gemarcano/wifi_pc_power_switch/(threads)

Thread 1 (2024-11-17):

Add a reset button

gemarcano, 2024-11-17:
It's a royal pain to reset the board if the software hangs, as it requires pulling power (or shorting the reset pin, but that's also a pain).

gemarcano, 2024-11-26:
Added in 0155b61027025464fed4fbbf1b67137adf696be9.

Closed 2024-11-26.

Thread 2 (2024-11-17):

Add LED indicator for 5V input rail

gemarcano, 2024-11-17:
Right now it's very difficult to determine if the 5V input (non-USB) on the board is receiving power. This is used by the 5VSB connection on my ATX motherboard.

gemarcano, 2024-11-26:
Added in current Rev B (commit 0155b61027025464fed4fbbf1b67137adf696be9).

Closed 2024-11-26.

Thread 3 (2024-11-17):

Firmware: Crashes intermittently after a long while

gemarcano, 2024-11-17:
Need to implement better logging that either sends it somewhere or stores somewhere in SRAM that survives reboot. But after 8+ hours the pico reboots probably due to a crash.

gemarcano, 2024-12-06:
My guess is that there's some kind of buffer overflow happening with logging. I thought I limited the amount of memory being used by logging... I'll double check the logic. Another option I have is I can add a loop that just prints crap to log continuously to try to crash the system faster.

gemarcano, 2024-12-06:
Should be fixed by https://github.com/gemarcano/gpico/commit/f45d731c7d10dc535cbf3f118748629627a8f622 . Effectively we were using too much heap memory, since we don't know the overhead malloc requires, and aren't taking into account possible fragmentation. Just massively reduce the log size which should be pretty safe even with 10x overhead (honestly, we can probably increase the log size by 5x and still be fine).

Closed 2024-12-06.

Thread 4 (2024-11-17):

Firmware: moving CLI task initialization before WiFi leads to a crash

gemarcano, 2024-11-17:
See title. Will probably need to connect a debugger to see what's going on. I've already tried increasing heap and stack size, but that doesn't seem to work.

gemarcano, 2024-11-26:
Figured out the cause. It was resource starvation. FreeRTOS always runs tasks at the highest priority, and if these never block/sleep, they will starve lower priority tasks.

I've applied 2 fixes:
 1. Switch TinyUSB implementation to use FreeRTOS support, making the USB task actually block
 2. Change priorities around as there are some tasks made by pico-sdk networking that are only `idle+1`.

Closed 2024-11-26.
