gemarcano/wifi_pc_power_switch/design/wifi_pc_power_switch-F_Silkscreen.pdf

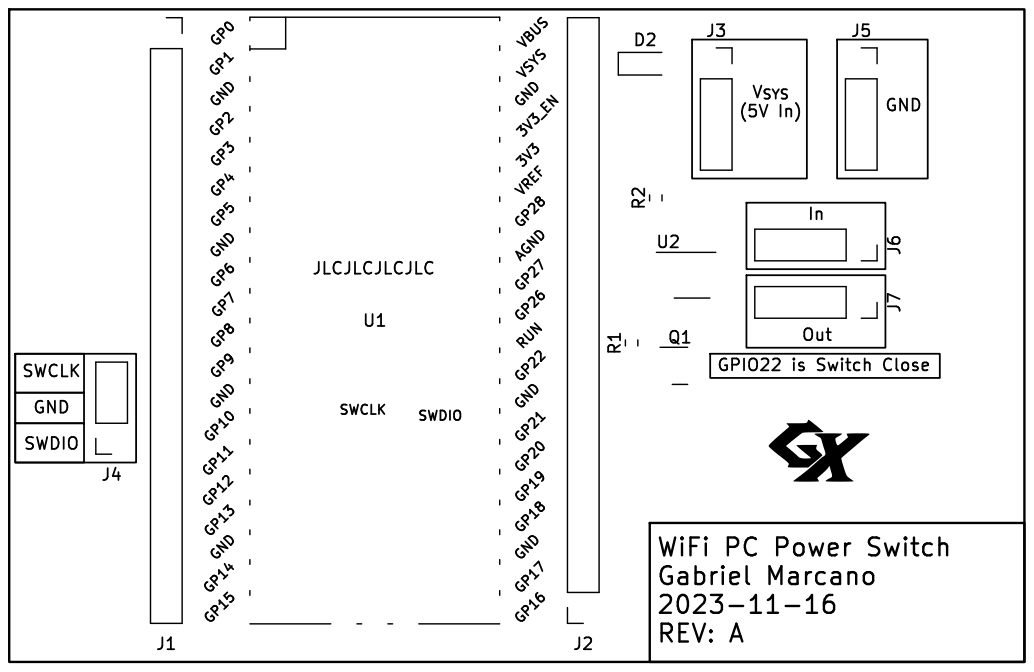
[picture p1: page 1]

GPIO22 is Switch Close GND
