gemarcano/wifi_pc_power_switch/design/wifi_pc_power_switch.pdf

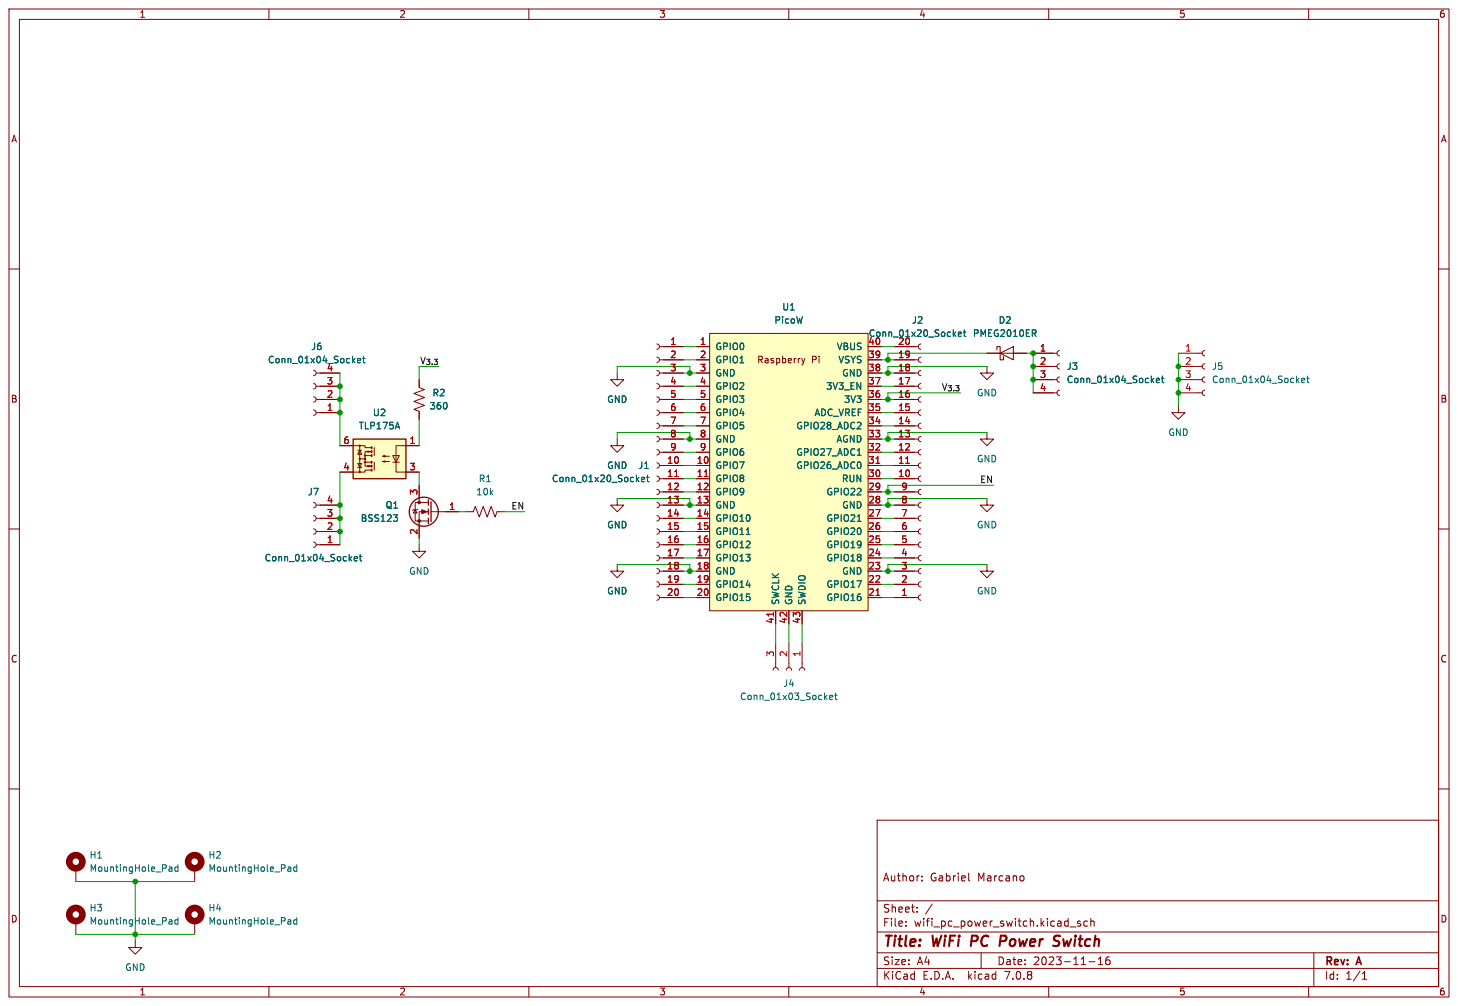
[picture p2: page 1]

Id: 1/1 Title: WiFi PC Power Switch
