gemarcano/wifi_pc_power_switch/design/wifi_pc_power_switch-B_Cu.pdf

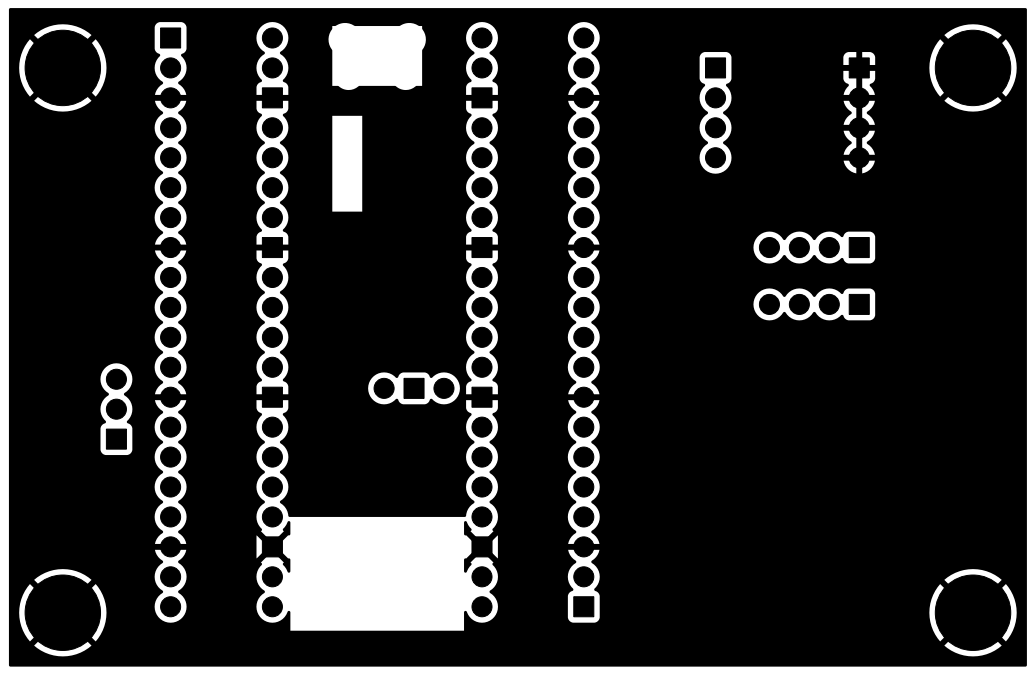
[picture p3: page 1]
