gemarcano/wifi_pc_power_switch/design/wifi_pc_power_switch-B_Mask.pdf

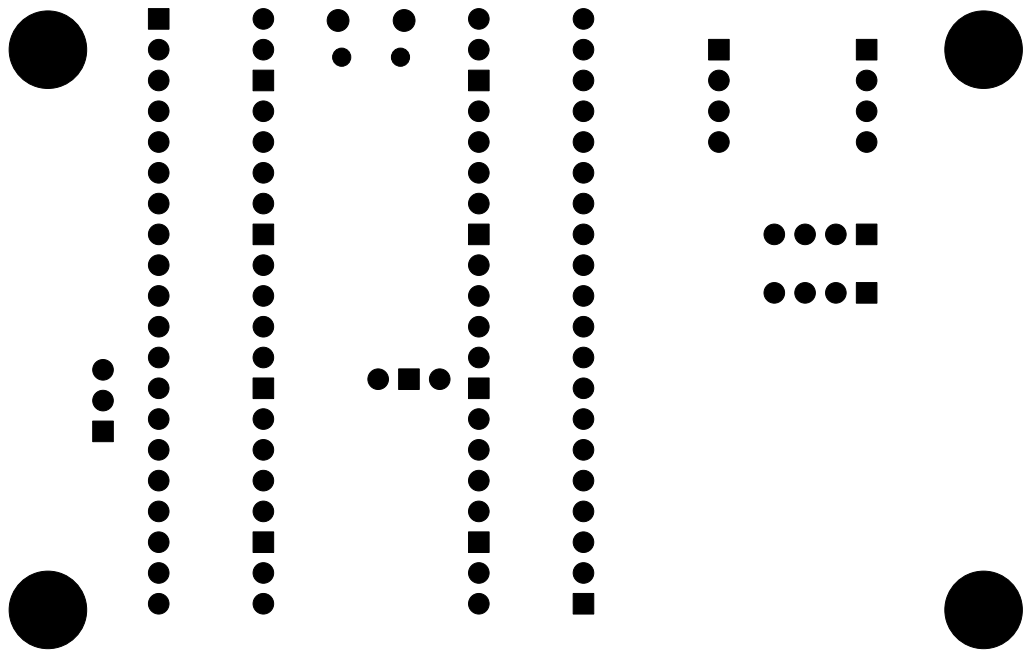
[picture p4: page 1]
