gemarcano/wifi_pc_power_switch/design/wifi_pc_power_switch-F_Cu.pdf

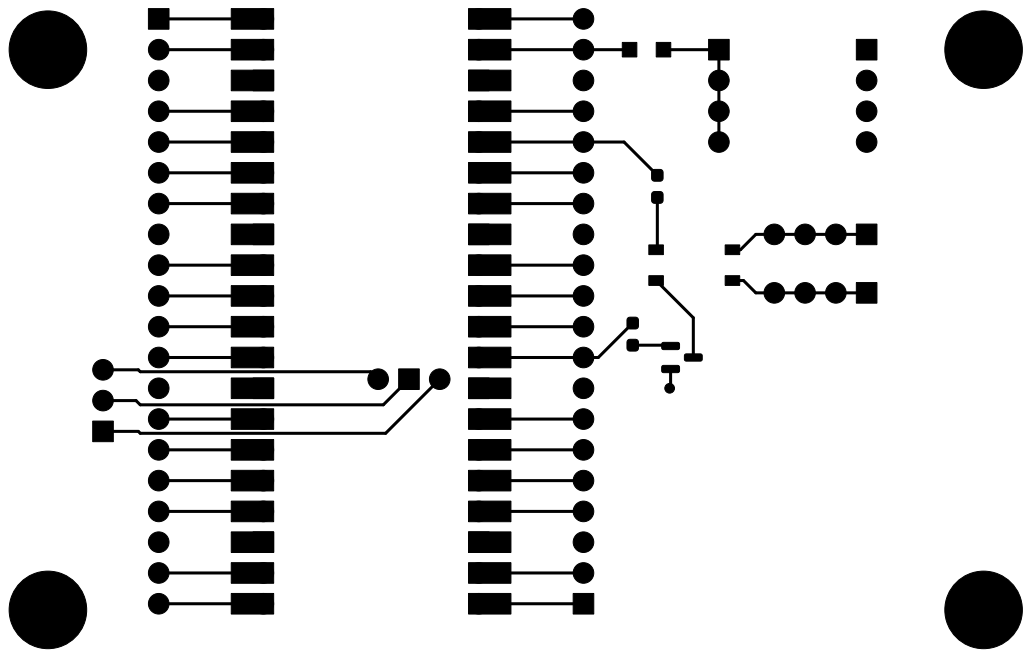
[picture p5: page 1]
