gemarcano/wifi_pc_power_switch/design/wifi_pc_power_switch-F_Mask.pdf

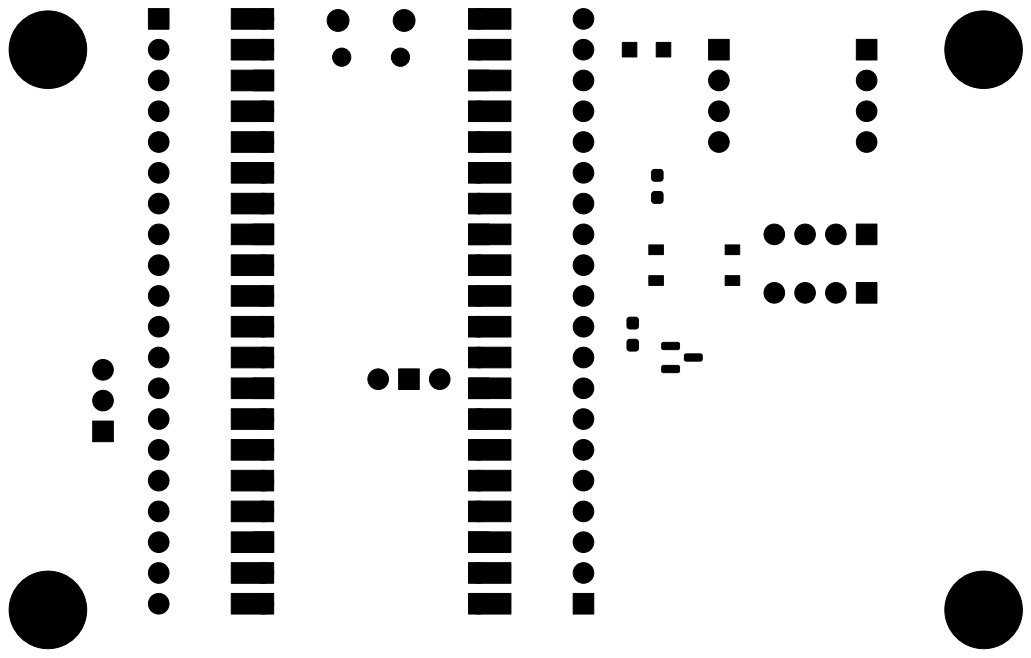
[picture p6: page 1]
