gemarcano/wifi_pc_power_switch/design/wifi_pc_power_switch-F_Paste.pdf

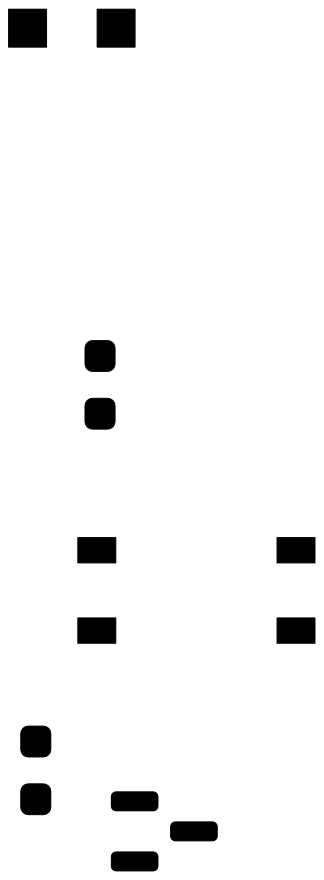
[picture p7: page 1]
