gemarcano/wifi_pc_power_switch/design/wifi_pc_power_switch_pcb.pdf

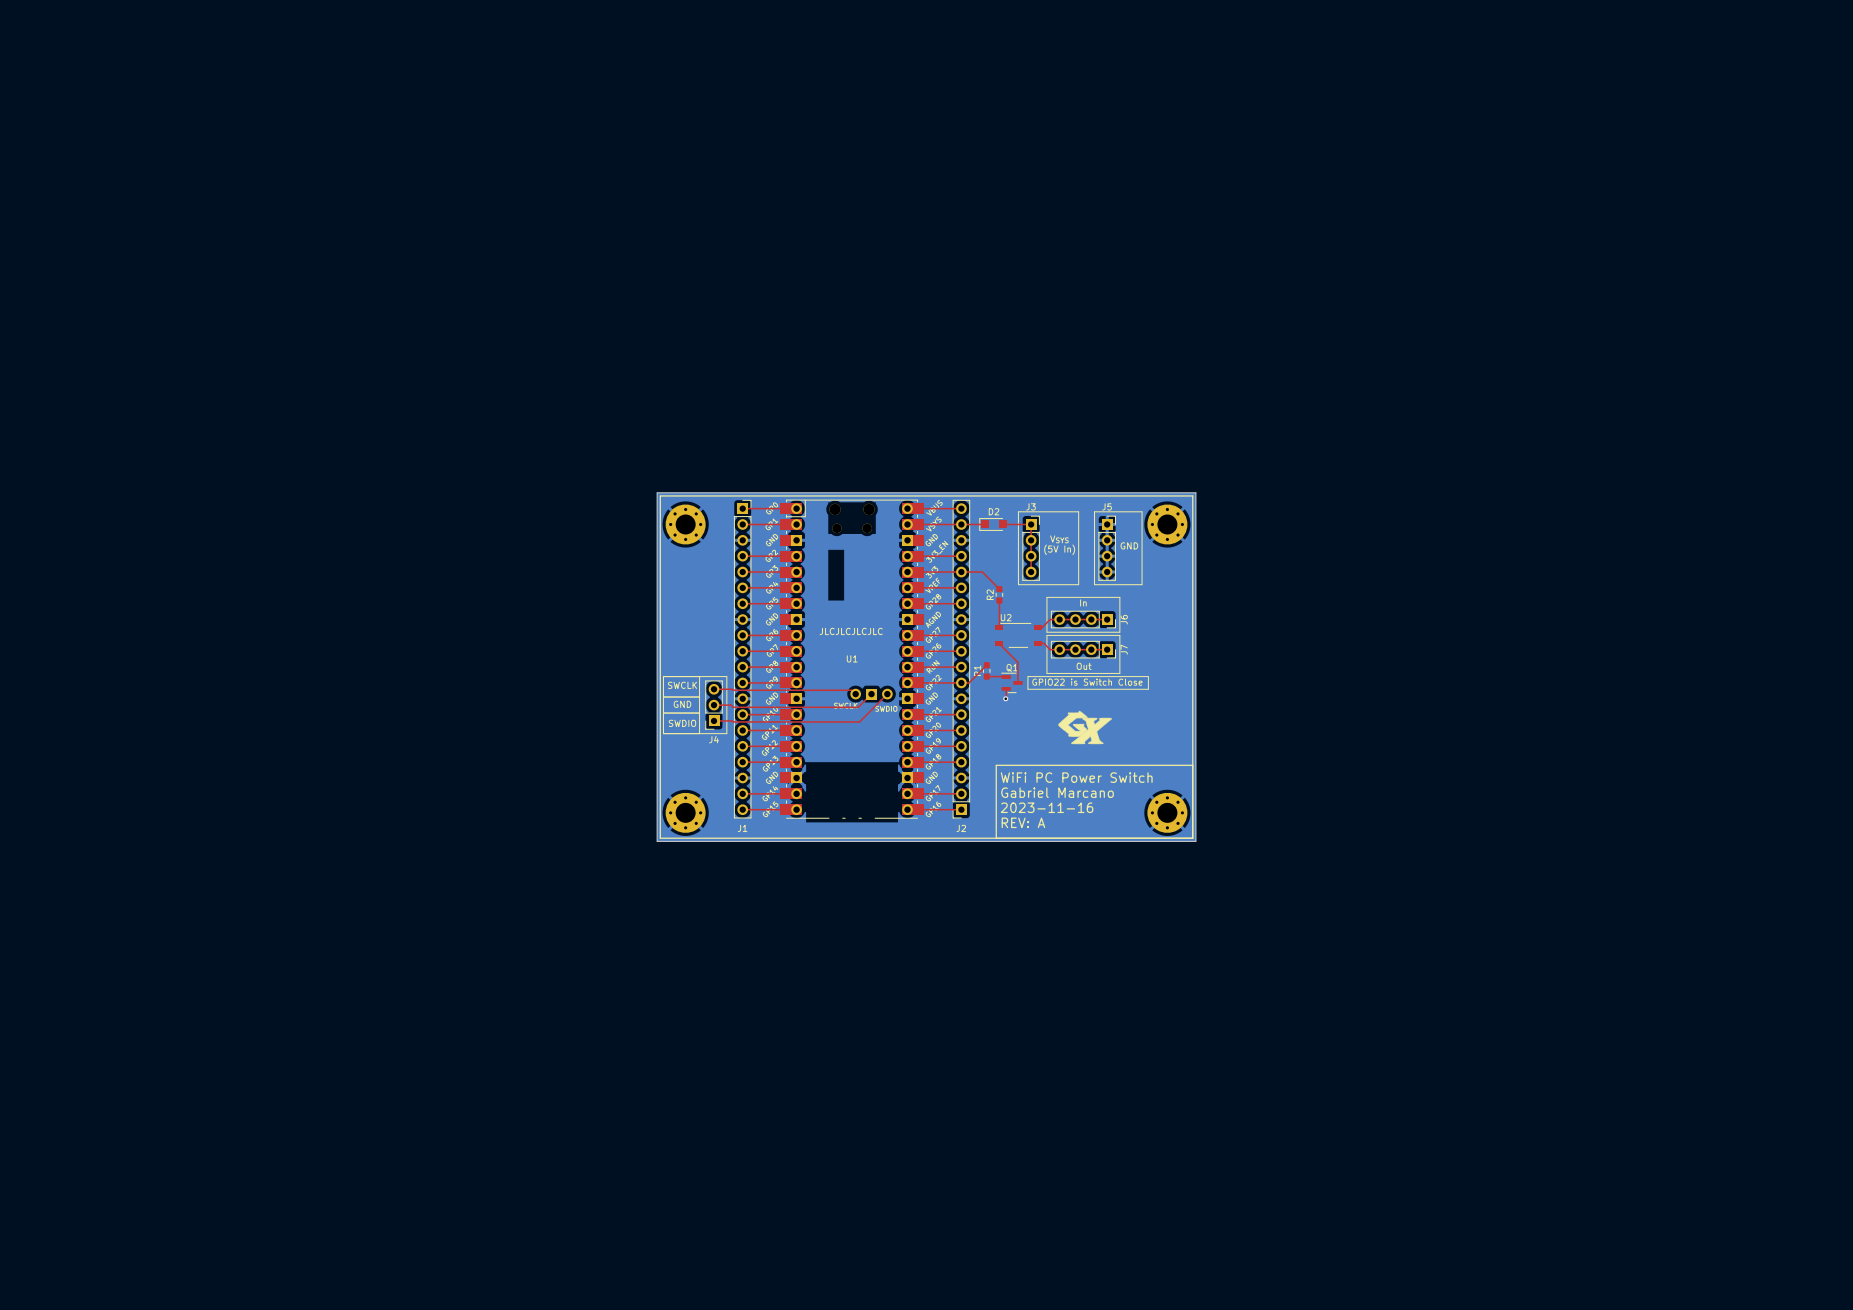
[picture p8: page 1]
