gemarcano/wifi_pc_power_switch/wifi_pc_power_switch.kicad_pcb

## KiCad design wifi_pc_power_switch.kicad_pcb (2025-06-24)

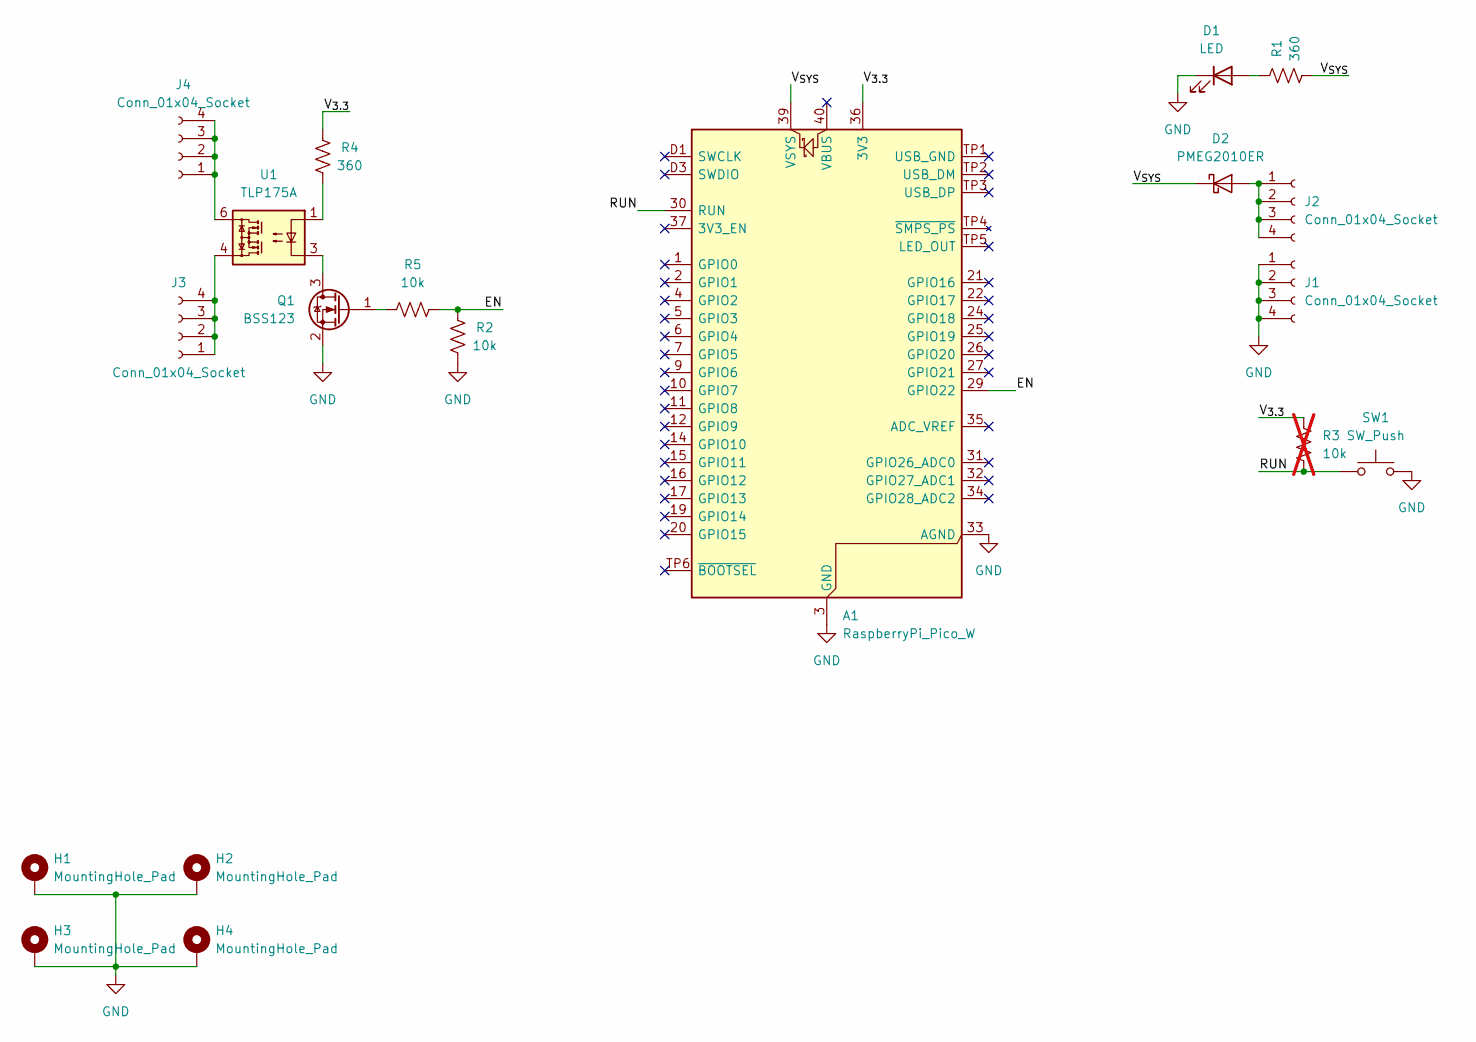
[picture p9: schematic wifi_pc_power_switch.kicad_sch, WiFi PC Power Switch]

Parts:
A1: RaspberryPi_Pico_W; RaspberryPi_Pico_W_Common_Unspecified
D1: LED; LED_0603_1608Metric_Pad1.05x0.95mm_HandSolder
D2: PMEG2010ER; Nexperia_CFP3_SOD-123W
H1, H2, H3, H4: MountingHole_Pad; MountingHole_3.2mm_M3_Pad_Via
J1, J2, J3, J4: Conn_01x04_Socket; PinSocket_1x04_P2.54mm_Vertical
Q1: BSS123; SOT-23
R1, R4: 360; R_0603_1608Metric_Pad0.98x0.95mm_HandSolder
R2, R5: 10k; R_0603_1608Metric_Pad0.98x0.95mm_HandSolder
R3: 10k; R_0603_1608Metric_Pad0.98x0.95mm_HandSolder; not fitted
SW1: SW_Push; PTS636_SM50_SMTR_LFS
U1: TLP175A; MFSOP6-4_4.4x3.6mm_P1.27mm

Connections:
/EN: A1.29 (GPIO22), R2.2, R5.2
/RUN: A1.30 (RUN), R3.2, SW1.1
/V_{3.3}: A1.36 (3V3), R3.1, R4.2
/V_{SYS}: A1.39 (VSYS), D2.1 (K), R1.1
GND: A1.3 (GND), A1.8 (GND), A1.13 (GND), A1.18 (GND), A1.23 (GND), A1.28 (GND), A1.33 (AGND), A1.38 (GND), A1.D2 (GND), D1.1 (K), H1.1, H2.1, H3.1, H4.1, J1.1, J1.2, J1.3, J1.4, Q1.2 (S), R2.1, SW1.2
unnamed: D1.2 (A), R1.2
unnamed: D2.2 (A), J2.1, J2.2, J2.3, J2.4
unnamed: J3.1, J3.2, J3.3, J3.4, U1.4
unnamed: J4.1, J4.2, J4.3, J4.4, U1.6
unnamed: Q1.3 (D), U1.3
unnamed: Q1.1 (G), R5.1
unnamed: R4.1, U1.1

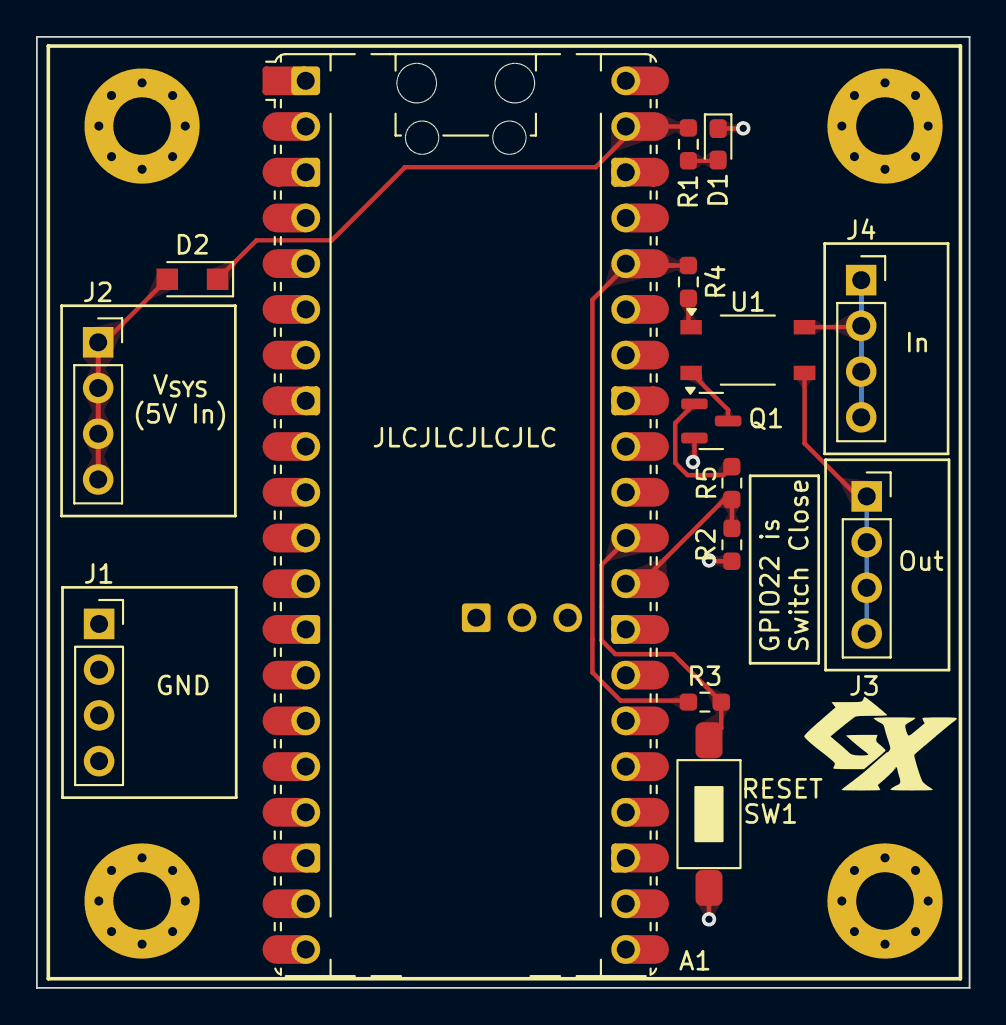
[picture p10: board wifi_pc_power_switch.kicad_pcb from above]

Board: 2 copper layers, 51.8 x 52.8 mm, 19 parts (0 on the bottom side), 12 nets.
