gemarcano/wifi_pc_power_switch/firmware/src/ntp.cpp

// SPDX-License-Identifier: GPL-2.0-or-later OR LGPL-2.1-or-later
// SPDX-FileCopyrightText: Gabriel Marcano, 2023 - 2024
/// @file

#include <pcrb/ntp.h>

#include <FreeRTOS.h>
#include <queue.h>
#include <task.h>

#include <pico/stdlib.h>
#include <pico/cyw43_arch.h>

#include <pcrb/switch.h>
#include <pcrb/server.h>

#include <lwip/dns.h>
#include <lwip/pbuf.h>
#include <lwip/udp.h>
#include <lwip/sockets.h>
#include <lwip/netdb.h>

#include <cstring>
#include <ctime>
#include <memory>
#include <expected>
#include <atomic>

constexpr const char* NTP_SERVER = "pool.ntp.org";
constexpr const int NTP_MSG_LEN = 48;
constexpr const int NTP_PORT = 123;
constexpr const int NTP_DELTA = 2208988800; // seconds between 1 Jan 1900 and 1 Jan 1970
constexpr const int ntpEST_TIME = (30 * 1000);
constexpr const int NTP_FAIL_TIME = (10 * 1000);

ntp_client::ntp_client()
{
	ip_addr_t dns_server;
	cyw43_arch_lwip_begin();
	inet_pton(AF_INET, "1.1.1.1", &dns_server);
	dns_setserver(0, &dns_server);
	cyw43_arch_lwip_end();
}

int ntp_client::request()
{
	// Look up IP address of NTP server first, in case we're looking at an
	// NTP pool
	const addrinfo ntp_info = {
		.ai_flags = 0,
		.ai_family = AF_UNSPEC,
		.ai_socktype = SOCK_DGRAM,
		.ai_protocol = 0,
	};
	addrinfo *dns_result = NULL;
	printf("Trying DNS...\n");
	int err = getaddrinfo(NTP_SERVER, "123", &ntp_info, &dns_result);
	printf("DNS err: %d %p\n", err, dns_result);
	printf("High water mark: %lu\n", uxTaskGetStackHighWaterMark(NULL));
	printf("%d %d %d\n", dns_result->ai_family, dns_result->ai_socktype, dns_result->ai_protocol);
	int s = socket(dns_result->ai_family, dns_result->ai_socktype, dns_result->ai_protocol);
	printf("socket: %d\n", s);
	timeval timeout = {
		.tv_sec = 5,
	};
	setsockopt(s, SOL_SOCKET, SO_RCVTIMEO, &timeout, sizeof(timeout));
	err = connect(s, dns_result->ai_addr, dns_result->ai_addrlen);
	printf("connect err: %d\n", err);
	freeaddrinfo(dns_result);

	unsigned char request[NTP_MSG_LEN] = {0};
	request[0] = 0x1b;
	int amount = send(s, request, NTP_MSG_LEN, 0);
	printf("amount sent: %d\n", amount);
	amount = ::recv(s, request, NTP_MSG_LEN, 0);
	printf("amount received: %d\n", amount);
	close(s);

	uint8_t mode = request[0] & 0x7;
	uint8_t stratum = request[1];

	// Check the result
	if (amount == NTP_MSG_LEN &&
		mode == 0x4 &&
		stratum != 0)
	{
		uint8_t seconds_buf[4] = {};
		memcpy(seconds_buf, request + 40, 4);
		uint32_t seconds_since_1900 = seconds_buf[0] << 24 | seconds_buf[1] << 16 | seconds_buf[2] << 8 | seconds_buf[3];
		uint32_t seconds_since_1970 = seconds_since_1900 - NTP_DELTA;
		time_t epoch = seconds_since_1970;
		struct tm *utc = gmtime(&epoch);
		printf("got ntp response: %02d/%02d/%04d %02d:%02d:%02d\n", utc->tm_mday, utc->tm_mon + 1, utc->tm_year + 1900,
			   utc->tm_hour, utc->tm_min, utc->tm_sec);
		ntp_timeout_time = make_timeout_time_ms(ntpEST_TIME);
		return 0;
	}

	printf("invalid ntp response\n");
	return -1;
}

bool ntp_client::time_elapsed() const
{
	printf("diff: %lld\n", absolute_time_diff_us(get_absolute_time(), ntp_timeout_time));
	return absolute_time_diff_us(get_absolute_time(), ntp_timeout_time) < 0;
}
