gemarcano/wifi_pc_power_switch/firmware/src/network_task.cpp

// SPDX-License-Identifier: GPL-2.0-or-later OR LGPL-2.1-or-later
// SPDX-FileCopyrightText: Gabriel Marcano, 2023 - 2024
/// @file

#include <pcrb/network_task.h>
#include <pcrb/switch_task.h>
#include <pcrb/server.h>

#include <gpico/log.h>

#include <cstdint>
#include <cstdio>
#include <format>
#include <cstring>

using gpico::sys_log;

namespace pcrb
{

void network_task(void*)
{
	// Loop endlessly, restarting the server if there are errors
	server server_;

	for(;;)
	{
		// FIXME maybe move wifi initialization here?
		int err;
		do
		{
			err = server_.listen(48686);
			if (err != 0)
			{
				sys_log.push(std::format("unable to listen on server, error {}", err));
			}
		} while (err != 0);

		for(;;)
		{
			auto accept_result = server_.accept();
			if (!accept_result)
			{
				sys_log.push(std::format("unable to accept socket, error {}", accept_result.error()));
				// FIXME what if the error is terminal? Are there any terminal errors?
				continue;
			}
			sys_log.push("new connection accepted");
			auto request_result = server_.handle_request(std::move(*accept_result));
			if (request_result)
			{
				if (request_result.value().size() != 4)
				{
					sys_log.push(std::format("Received bad network request with size {}", request_result.value().size()));
					continue;
				}
				uint32_t request;
				memcpy(&request, request_result.value().data(), request_result.value().size());
				request = ntoh(request);
				sys_log.push(std::format("Received network request {}", request));
				xQueueSendToBack(switch_comms.get(), &request, 0);
			}
			else
				sys_log.push(std::format("failed to handle request: {}", request_result.error()));
		}

		server_.close();
	}
}

}
