gemarcano/wifi_pc_power_switch/(commit log)

2023-11-09 Switch to using sockets API
2023-11-17 Add pull-down to establish default switch state
    - Also force keep-out areas to be where they matter-- for USB and
    antenna, keep-out for both top and bottom layers. For test pads,
    keep-out only on top layer.
    [wifi_pc_power_switch.kicad_pcb, wifi_pc_power_switch.kicad_sch]
2023-12-07 Reorganize source directories
    - Initial GPIO implementation to control solid state relay
2023-12-09 Remove NTP from main
    - This project doesn't really need NTP
    [main.cpp]
2023-12-16 Better FreeRTOS malloc support
    - Turns out that for multi-thread malloc support we need to implement
    recursive locking of the malloc control structures through
    __malloc_lock and __malloc_unlock
    - Enable Newlib _reent support in FreeRTOS
    - Enable static allocation support in FreeRTOS
2023-12-23 Trivial CLI support, lwip status callbacks
    - Register trivial handlers to detect when lwip network status changes
    - Add a trivial CLI interface to toggle the switch over USB, and to
    query basic network state
2023-12-23 Add syslog support, cleanup init printing
    - Also, just move all initialization to the init_task-- it really just
    looks like with FreeRTOS the pico-sdk just makes too many assumptions
    that tasks, mutex/spinlocks, etc. are running inside tasks, so do the
    absolute bare minimum in main() to launch a FreeRTOS task.
2023-12-23 socket wrapper class, new namespace
    - Make new socket wrapper class, to handle closing automatically
    - Stick server and socket classes in new pc_remote_button namespace, to
    prevent clash with global namespace symbols
    [main.cpp]
2023-12-23 removed custom malloc protection, watchdog support
    - Turns out the pico-sdk is already doing locking through __wrap_malloc
    and friends. Something weird was going on that was causing a race
    between the two cores with my custom implementation, leading to a
    vListInsert looping forever because the node points to itself. I'm
    still not sure why this manifests (supposedly interrupt priority
    errors in Cortex-Ms are a usual suspect, as well as stack overflows).
    - Enable watchdog support. In case we do end up crashing, now this
    should enable us to recover automatically
    [main.cpp]
2023-12-25 Add more error checking for networking
    - Loop server init and close in case of errors
    [main.cpp]
2024-01-14 Move most output to log, track time in log
    - Status output now also prints logs
2024-01-14 Move switch into switch task
    - Ensure only switch task can control switch
2024-01-15 Replace snprintf with std::format
    [main.cpp]
2024-01-15 Refactor out of main, use newlib errno
    - Refactor most tasks out of main.cpp, and isolate them as much as
    possible
    - switch_task exposes a global singleton to access the switch queue to
    pass switch times
    - Change copyright years
    - log exposes sys_log global log variable
    - Apparently pico-sdk uses LWIP_PROVIDE_ERRNO = 1, which makes newlib
    throw up a ton of warnings depending on the include order. Undef it
    and let LWIP use newlib's errno instead
2024-01-16 Log when switch is toggled
2024-01-16 Force a full reset if we fail initialization
    [main.cpp]
2024-01-16 socket debug logging, fix socket move, stack size
    - Add more logging to view stack watermark
    - Increase CLI stack, was overflowing
    - Fix socket move constructor, always initialize internal socket handle
    [cli_task.cpp, main.cpp, network_task.cpp, server.cpp, switch_task.cpp]
2024-01-16 Improve handle_request move, shutup GCC format abi
    - Take socket by value forcing a move in handle_request, which also
    leads to automatic destruction of the object on function return as
    intended
    - add -Wno-psabi to shut up GCC from throwing up notices on std::format
    use
2024-01-17 Disable powersaving mode
    - Trying to improve reliability-- disable power saving in WiFi. We're
    plugged into main power so this should be fine. Doesn't seem to
    improve pings, though
    [main.cpp]
2024-02-05 Ensure power mode gets changed, more log output
    - Power mode change doesn't stick unless it happens after wifi is
    initialized, so move it to after we connect
    - Add more logging output when a change in link and status is detected
    [cli_task.cpp, main.cpp]
2024-02-06 A lot more debugging output for wifi state
    - Added RSSI and link state output to determine what's going wrong and
    when
    - Move power management after setting sta mode
    - fix bug in reconnect attempt, had inverted logic
    [cli_task.cpp, main.cpp]
2024-02-07 new wifi management task, lower priority of others
    - Lower the priority of all tasks I create to make sure network task is
    prioritized
    - Dedicated wifi management task that monitors every second for changes
    to link status, since apparently there can be some changes that
    aren't detected by the driver/pico-sdk network layers
    - tweak logging output to make it easier to figure out who's printing
    what
    - wifi management task now in charge of reconnection
2024-02-19 wifi: move from main, check lwip flags also
    - Apparently checking pico cyw43 status isn't enough-- it always
    returns JOIN even if lwip reports a link change/drop. Also check LWIP
    flag and try to reconnect if we lose the link.
2024-02-20 Remove socket debug logging
    - I'm pretty sure the basic socket construction logic works now, remove
    the logging. In the future, we may want to extend logging to have
    different levels.
2024-03-11 Add .gitignore with KiCAD information
2024-03-12 Add pcrb namespace, use last code from sctu
    - Copy the latest networking code from snes_controllers_to_usb project,
    before I removed it from that directory (I really should make a pico
    library of my stuff).
    - Move almost everything to the pcrb (pc_remote_button) namespace.
    - Also copied latest watchdog code from sctu.
    - Updated to use xTaskCreateAffinitySet instead of xTaskCreate.
2024-03-14 Add MPU support, fix kill/reboot commands
    - Add MPU support, blocking access to the first 256 bytes of memory to
    catch null-pointer dereferences. This breaks USB auto-reboot,
    however...
    - Fix kill command by increasing the max length of the task names, and
    using the right name to kill one of the watchdog tasks.
    - Fix the reboot command by disabling the MPU before issuing a usb
    reboot function call.
    [cli_task.cpp, main.cpp]
2024-03-14 Remove MPU code, breaks rp2040 bootrom funcs
    - rp2040 bootrom has functions in bootrom, which starts at address 0x0.
    One of these is the usb reset function, used by cli "r" command and
    by the pico-sdk's vendor reboot interface. While I can disable the
    MPU in my code, I can't do the same for pico-sdk's without patching
    it, or without taking over tinyusb, so just disable the MPU.
    [cli_task.cpp, main.cpp]
2024-06-22 Pull in gpico library
    - gpico library provides syscalls for IO, but requires some USB
    plumbing (maybe I should have it provide said plumbing?). Add
    plumbing in main
    - gpico takes care of watchdogs, and provides auxiliary FreeRTOS
    functions. Beware, it is opinionated and expects Heap4
    implementation.
    - Logging is provided by gpico as well.
    - Add missing format includes in some files.
    [cli_task.cpp, log.h, main.cpp, network_task.cpp, server.cpp, switch_task.cpp, syslog.h, tusb_config.h]
2024-11-13 Update for pico-sdk version 2
2024-11-15 Don't wait for CDC, halt FreeRTOS for programming
    - Don't wait until we get a CDC connection to start everything up...
    that requires someone to connect over serial
    - For some reason trying to switch to programming boot mode is hanging
    sometimes. I think it's because it relies on a watchdog firing, and
    if the right FreeRTOS task stays alive constantly petting the
    watchdog, the reset will never happen. As such, for reboot, halt the
    FreeRTOS scheduler completely.
    [cli_task.cpp, main.cpp]
2024-11-22 Tweak task priorities to avoid starvation
    - CLI and USB tasks are very time hungry, and not super extremely time
    sensitive, so reduce their priority below other things. Also, it
    looks like the Pico SDK FreeRTOS support hard-codes some TCP tasks to
    a priority of IDLE+1, so be mindful of not starving those either.
    [main.cpp]
2024-11-25 Use TinyUSB FreeRTOS support, set board to pico_w
    - Hard-code board type to pico_w because that's all we support
    - By default TinyUSB uses Pico OS baremetal support with the pico-sdk
    (I'm guessing locking and what-have-you). Use FreeRTOS instead,
    especially since we're not using pico-sdk stdout implementation
    anyway
2024-11-26 Revision B*: Tentative making everything denser
    - Added 5V notification LED, so it's easier to tell when the board is
    actually powered
    - Condensed the board appreciably
    [wifi_pc_power_switch.kicad_pcb, wifi_pc_power_switch.kicad_sch]
2025-06-24 Add preliminary pico interface reboot support
    [wifi_pc_power_switch.kicad_pcb, wifi_pc_power_switch.kicad_sch]
2025-06-24 Use new gpico reset functions
    - except for baud method, just in case for now
    [cli_task.cpp]
2025-06-25 Improve handle_request
    - handle_request no longer assumes 4 bytes input, it assumes 2 bytes
    first, stating how much to read afterwards, up to 64 bytes.
    - adjusted the rest of the network_task to use this new functionality,
    and fixed a bug in what std::expected to actually be using (should
    use the handle_request one, not the accept one)
    [network_task.cpp, server.cpp]
2025-07-09 We don't need that many pins, add sense
    - Reduce the 4x pins to 2x, and place them near the edge (to be used
    with simple screw terminals)
    - Add a sense line, so the MCU can tell if the computer is on. It needs
    a pulldown due to rp2350 E9 errata.
    [wifi_pc_power_switch.kicad_pcb, wifi_pc_power_switch.kicad_sch]
2025-07-10 Add new monitor task
    - Monitor task monitors the PC power state through pin 21. This pin
    should be connected to one of the 3.3V power pins on the ATX
    motherboard connector (or any other 3.3V pin on the motherboard).
2025-07-12 Split commands from CLI
    - This is in preparation to allowing CLI access over the network
    - There's something wrong with the way printf is working-- it seems to
    hang the cli task somehow? Need to dig into it
    [cli_task.cpp, network_task.cpp]
2025-07-12 Increase stack switch task, up priority for cli
    - Switch task apparently was running out of memory
    - Something (not sure what, yet) was starving the CLI task out of time.
    Up the priority to match everything else.
2025-07-12 Fixed USB starving tasks, add priority to status
    - gpico fixes USB task starving all others by delaying by one tick
    (need to figure out why the FreeRTOS blocking isn't being used)
    - Add priority to status printout for each task
    [cli_task.cpp, main.cpp]
2025-07-12 network: add magic to header, add socket timeout
2025-07-13 network: improving error messages
    [network_task.cpp, server.cpp]
2025-07-14 network: support for sensing power
    - Allows query of 3.3V PC rail over pin 21 over network
    - Fixed bug with timing of network toggle parameter sent to switch task
    [cli_task.cpp, network_task.cpp]
2025-07-22 Improve MQTT handling
    - Had to increase stack size for lwip thread
